edwinmol/LED-Christmas-Tree/design/tree_sketch.jpg

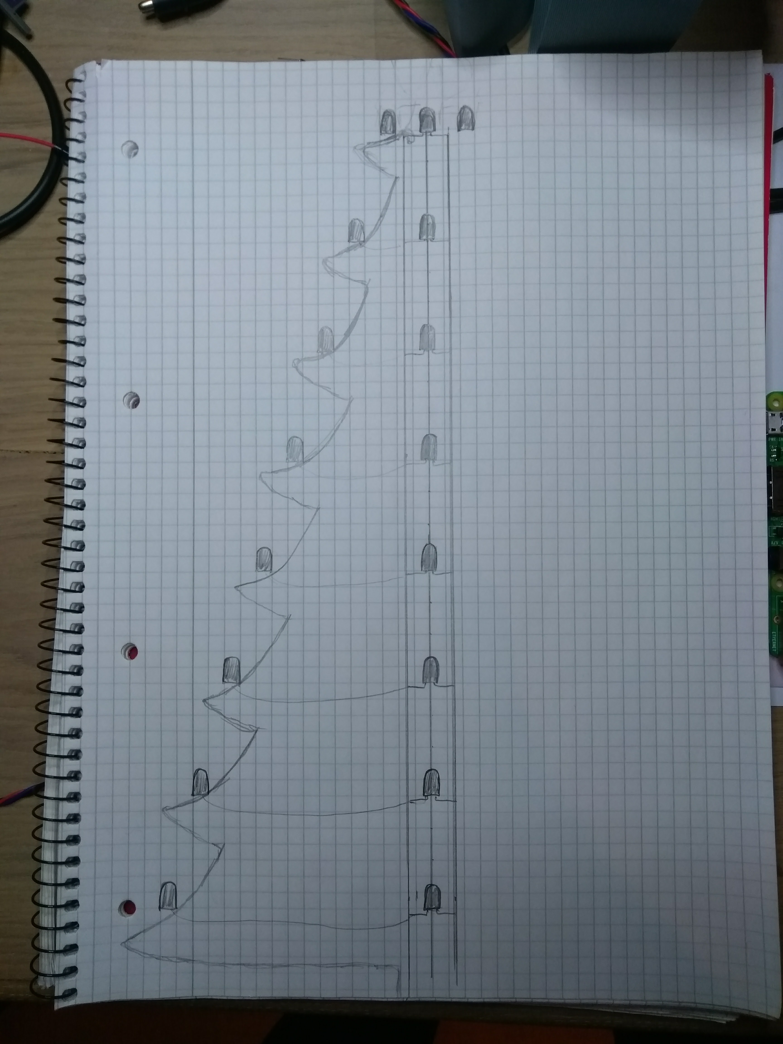
design/tree_sketch.jpg
