edwinmol/LED-Christmas-Tree/design/tree_cardboard_1.jpg

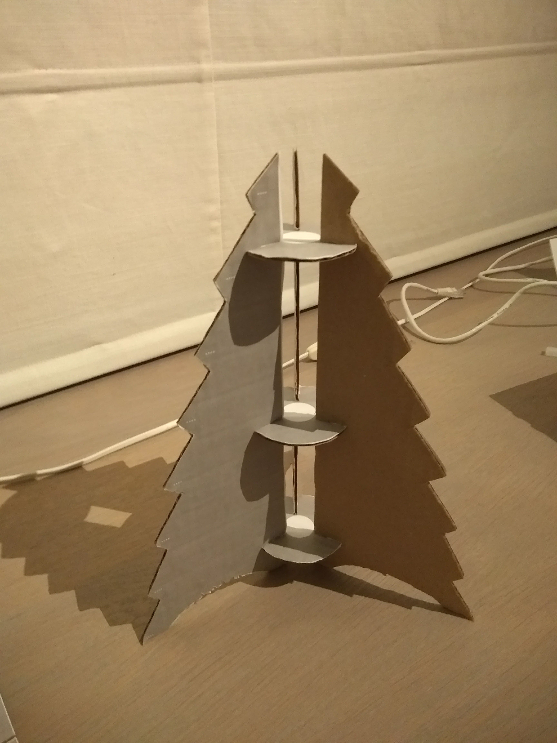
design/tree_cardboard_1.jpg
