edwinmol/LED-Christmas-Tree/README.md

# LED-Christmas-Tree
A raspberry Pi Xmas project

## Planning
* ~~draft BOM and order components (budget=100€)~~
* ~~design case + LED tree~~
* ~~design schematic of controller~~
* ~~construct LED tree~~
* ~~construct case~~
* ~~create controller PCB according to schematic~~
* ~~assembly of the final tree + casing~~
* ~~prototyping (proof of concept)~~
* programming raspberry PI
  * Select programming language (Python, C/C++, Java, other..) : done
  * API definition
  * Animations
  * Musicfragments or voice messages
