edwinmol/LED-Christmas-Tree/design/coordinaten.png

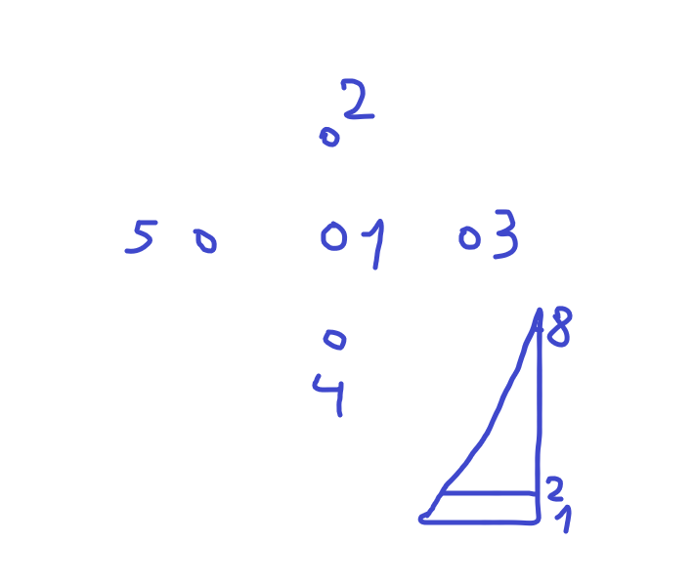
design/coordinaten.png
