edwinmol/LED-Christmas-Tree/design/tree_cardboard_2.jpg

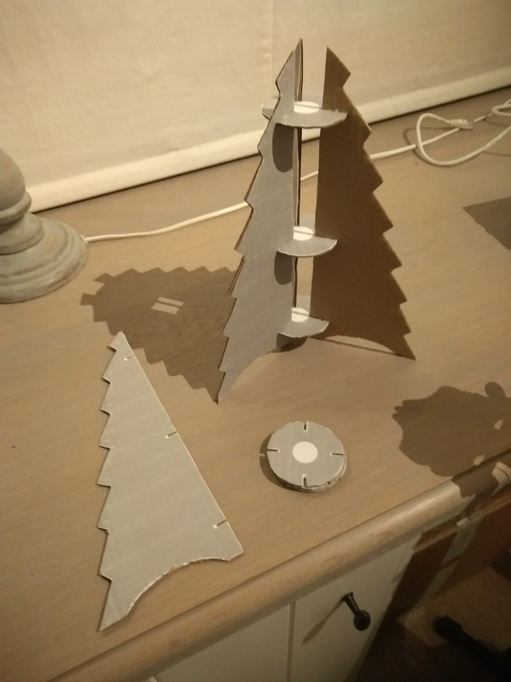
design/tree_cardboard_2.jpg
