edwinmol/LED-Christmas-Tree/bom/components.xlsx

Kerstboom componenten
beschrijving | type | url | datasheet | prijs | aantal | prijs incl. BTW
raspberry pi 3 | Raspberry Pi 3 Model B, Quad Core 1.2GHz CPU, 1GB RAM, WiFi/BLE, 40 GPIO Pins | http://be.farnell.com/raspberry-pi/raspberrypi-modb-1gb/raspberry-pi-3-model-b/dp/2525225 | http://www.farnell.com/datasheets/2027912.pdf | 32.69 | 1 | €39.55
led driver ic | MAX6969ANG+ | http://be.farnell.com/maxim-integrated-products/max6969ang/led-driver-constant-current-dip/dp/2516081 | http://www.farnell.com/datasheets/2002194.pdf | 5.59 | 2 | €13.53
P-Channel MOSFET | IRF9Z34NPBF - MOSFET Transistor, P Channel, 17 A, -55 V, 100 mohm, -10 V, -4 V | http://be.farnell.com/infineon/irf9z34npbf/mosfet-p-55v-17a-to-220/dp/8648689 | http://www.farnell.com/datasheets/2043013.pdf | 0.787 | 10 | €9.52
100 RGB LED | https://www.amazon.de/Stück-Ultra-Helle-Indirekt-Common/dp/B00H96MFNI (https://www.amazon.de/St%C3%BCck-Ultra-Helle-Indirekt-Common/dp/B00H96MFNI) | https://www.amazon.de/Stück-Ultra-Helle-Indirekt-Common/dp/B00H96MFNI (https://www.amazon.de/St%C3%BCck-Ultra-Helle-Indirekt-Common/dp/B00H96MFNI) |  |  | 1 | €7.99
luidspreker
PIR sensor | PIR Infrared Motion Sensor (HC-SR501) | https://www.kiwi-electronics.nl/pir-bewegingssensor?search=pir%20sensor |  |  | 1 | €6.95
behuizing
experimenteerbord
pi breakout board | 40-weg Cobbler Breakout Board voor Raspberry Pi - Voorgesoldeerd | https://www.kiwi-electronics.nl/raspberry-pi/gpio-accessoires/raspberry-pi-breakout-boards/40-weg-cobbler-breakout-board-voor-raspberry-pi-model-b-plus-voorge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 |  |  | 1 | 8.95
sd-card | Transcend 16GB microSD Premium 400x Class 10 UHS-I + Adapter - 60MB/s | https://www.kiwi-electronics.nl/Transcend-16GB-Class-10-MicroSDHC-UHS-1 |  |  | 1 | 11.95
 |  |  |  |  | Totaal | €98.45
