edwinmol/LED-Christmas-Tree/kicad/LED-Christmas-Tree.pdf

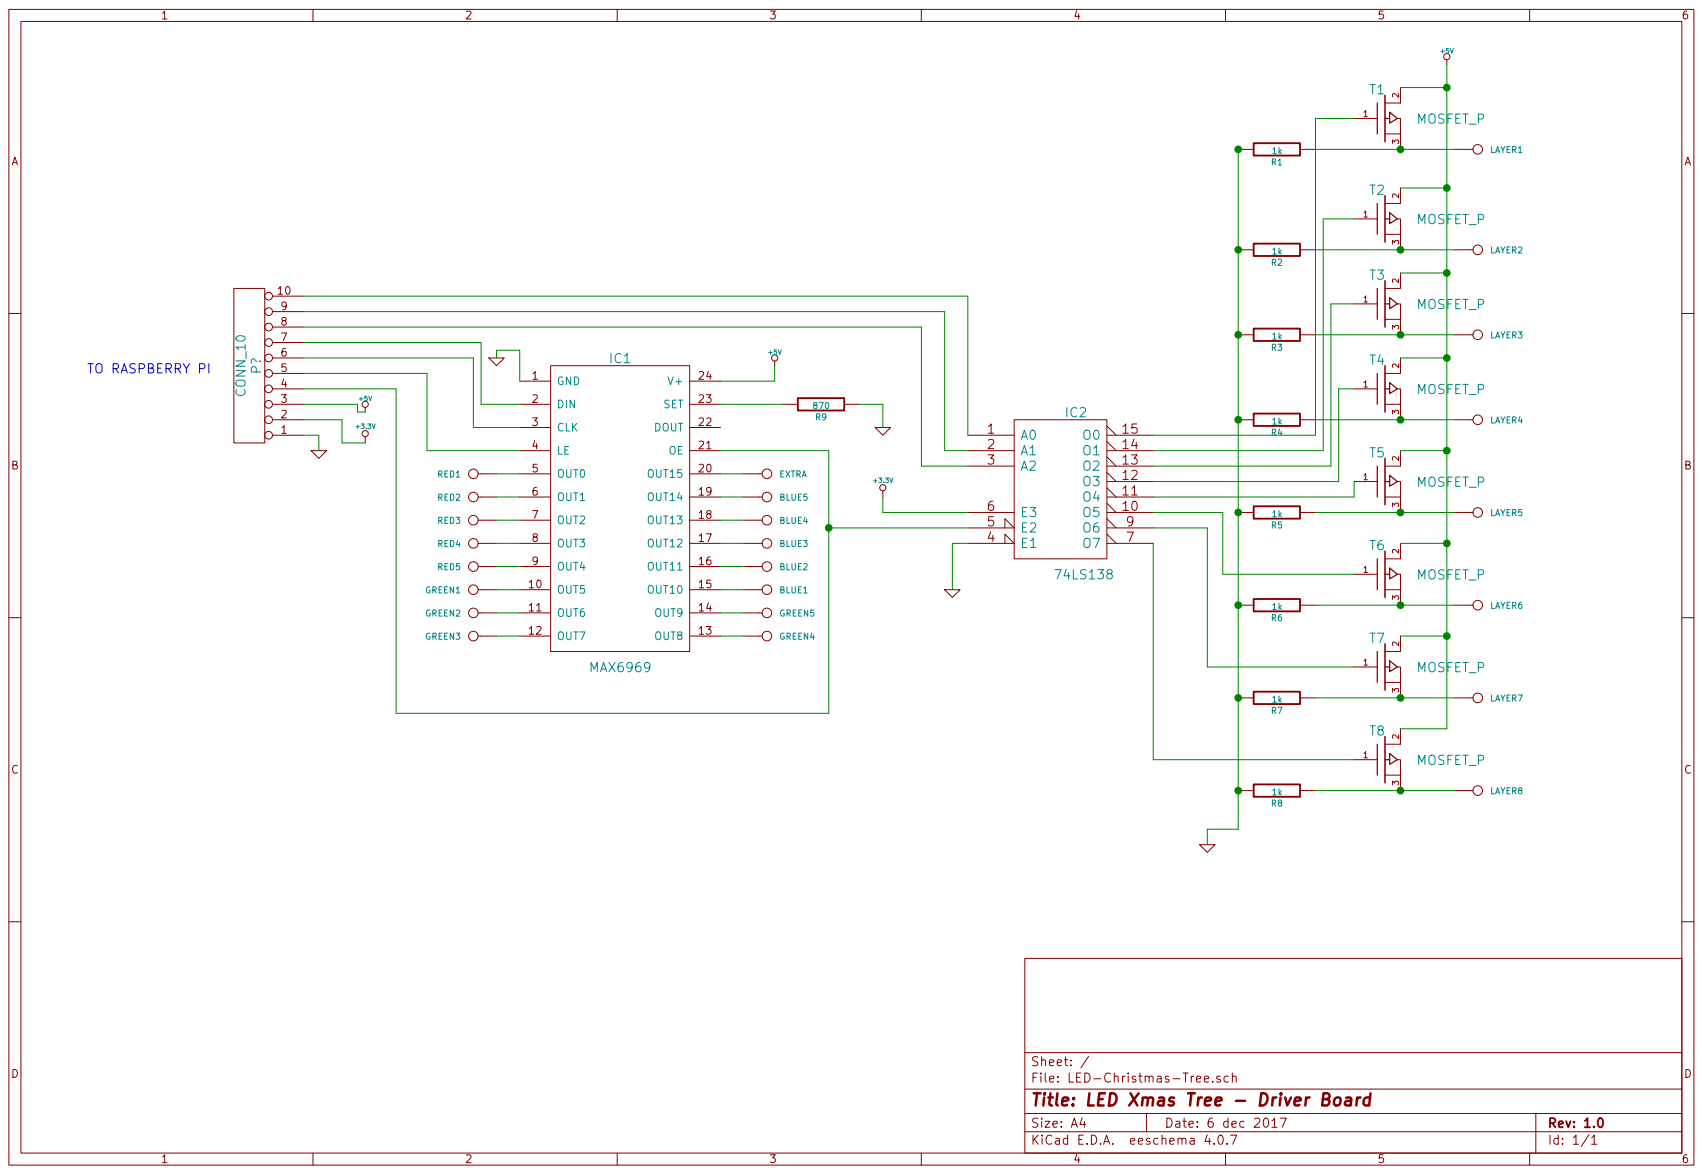
[picture p5: page 1]

File: LED-Christmas-Tree.sch Sheet: /
Id: 1/1 Title: LED Xmas Tree - Driver Board
