edwinmol/LED-Christmas-Tree/design/box.pdf

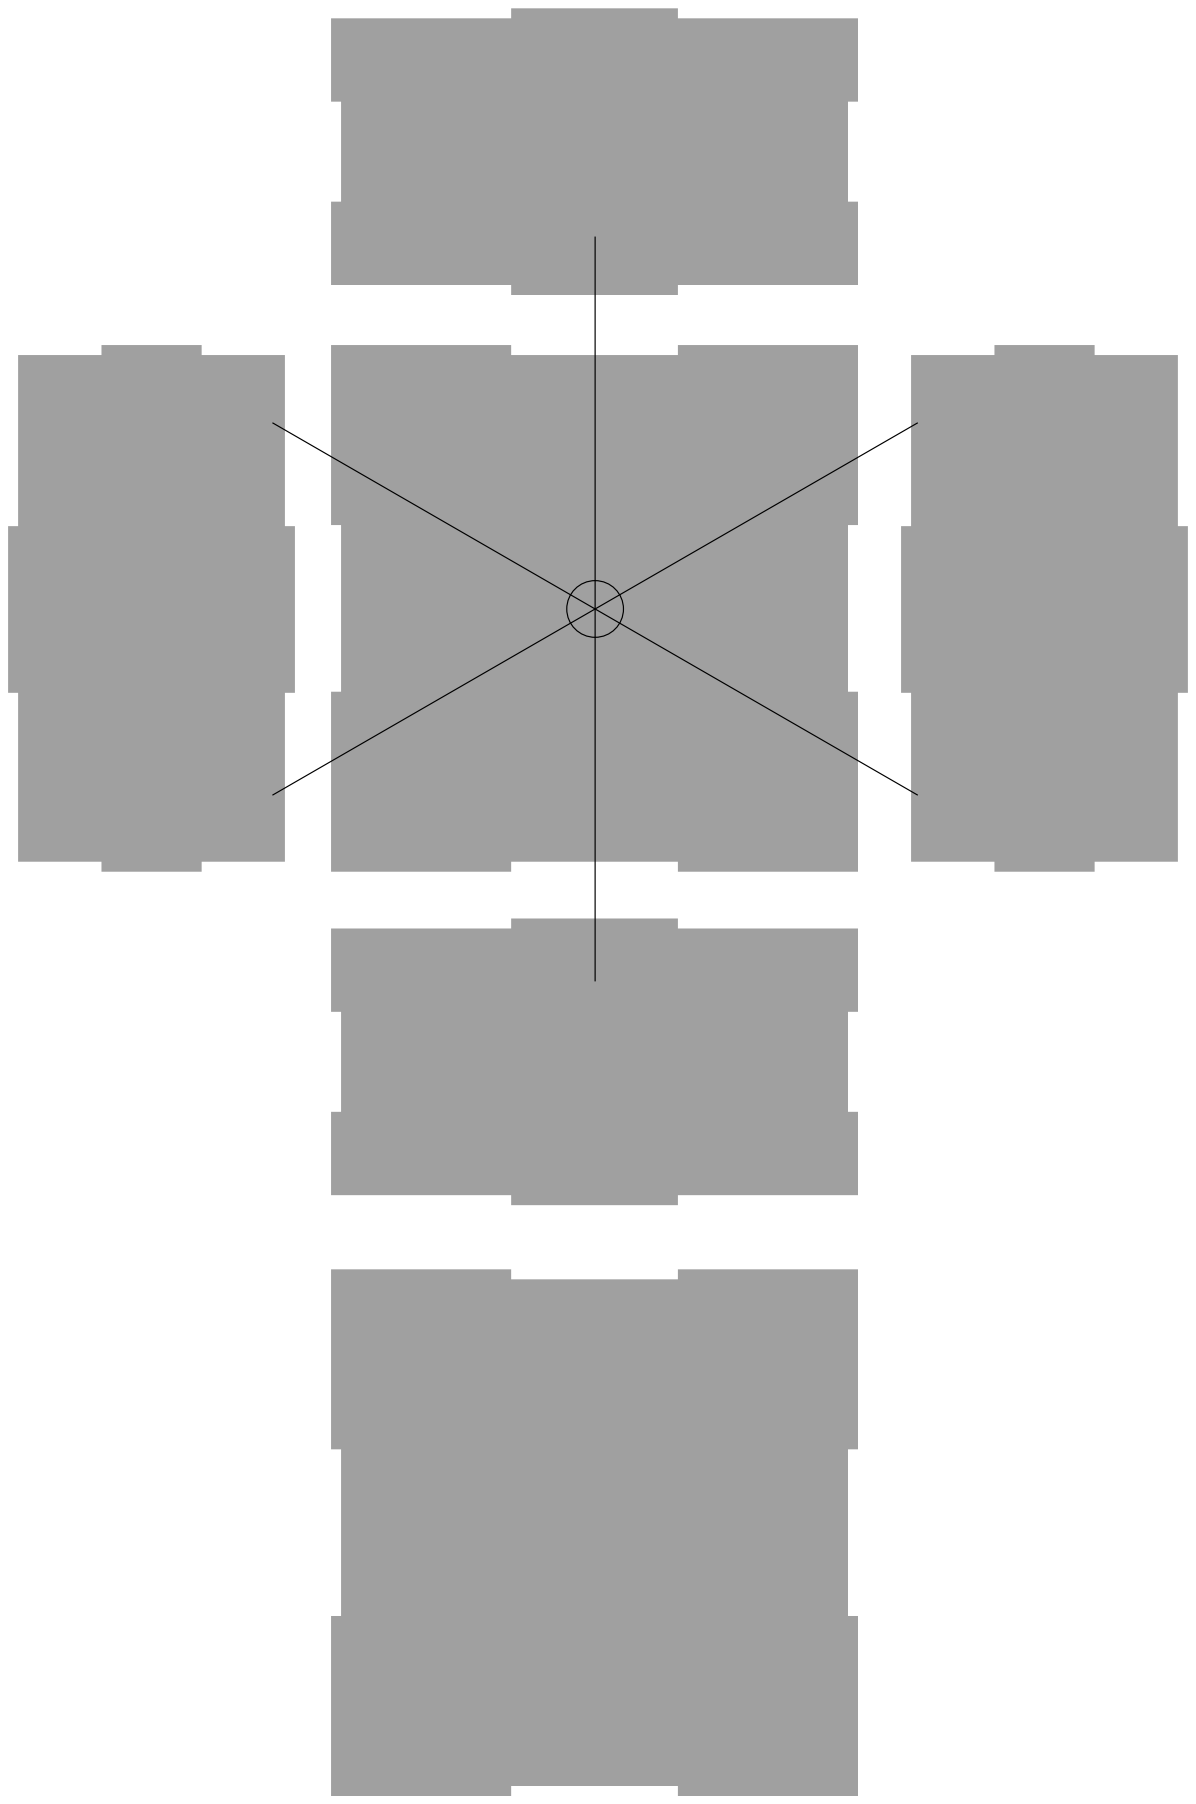
[picture p6: page 1]
