edwinmol/LED-Christmas-Tree/design/tree.pdf

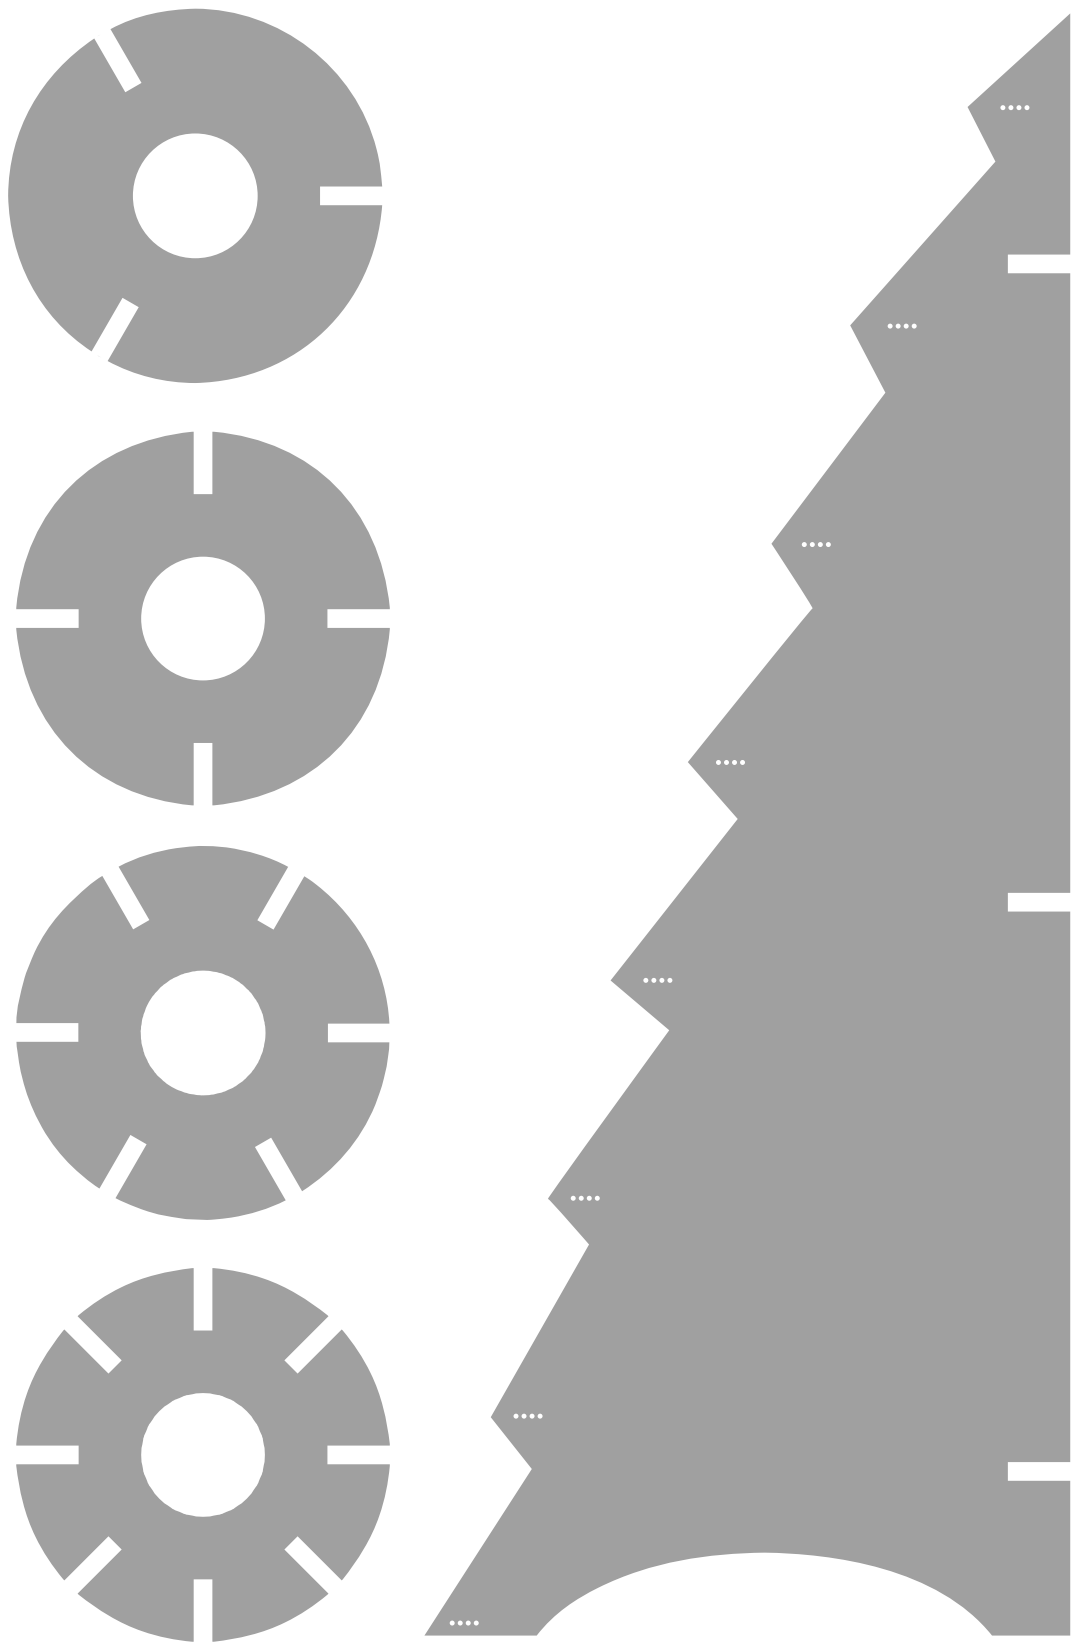
[picture p7: page 1]
