edwinmol/LED-Christmas-Tree/kicad/LED-Christmas-Tree.sch

## KiCad design kicad/LED-Christmas-Tree.sch (2017-12-06)

Schematic: LED-Christmas-Tree.sch

Parts:
BLUE1, BLUE2, BLUE3, BLUE4, BLUE5: CONN_1
EXTRA: CONN_1
GREEN1, GREEN2, GREEN3, GREEN4, GREEN5: CONN_1
IC1: MAX6969
IC2: 74LS138
LAYER1, LAYER2, LAYER3, LAYER4, LAYER5, LAYER6, LAYER7, LAYER8: CONN_1
R1, R2, R3, R4, R5, R6, R7, R8: 1k
R9: 870
RED1, RED2, RED3, RED4, RED5: CONN_1
T1, T2, T3, T4, T5, T6, T7, T8: MOSFET_P

Notes on the sheet:
TO RASPBERRY PI
