edwinmol/LED-Christmas-Tree/(commit log)

2017-12-06 added LED driver schematic + BOM
    [LED-Christmas-Tree.sch, components.xlsx]
2017-12-09 Intermediate commit - work unfinished with errors in multiplexing.
    [core.py, led_cube.py]
2017-12-12 Fixed some code in Multiplexer and deleted timers
    [core.py]
2017-12-12 added arduino controller code
2017-12-13 Cleanup of led_cube and deleted bam filling in Multiplexer thread
